LM13700/MAX30100_SaW_2022/README.md

Project for SaW course 2022, group 23, MAX30100 library. <br />
[Hardware](Hardware) - folder Altium PCB project. <br />
[Software](Software) - MAX30100 test project, also includes python script used for parsing data from sensor
