LM13700/MAX30100_SaW_2022/Documentation.pdf

Sensory w Aplikacjach Wbudowanych

# Dokumentacja techniczna

# Pulsoksymetr optyczny

Autorzy:
Mateusz Mróz
Filip Imiela

Prowadzący:
inż. mag. Jan Macheta

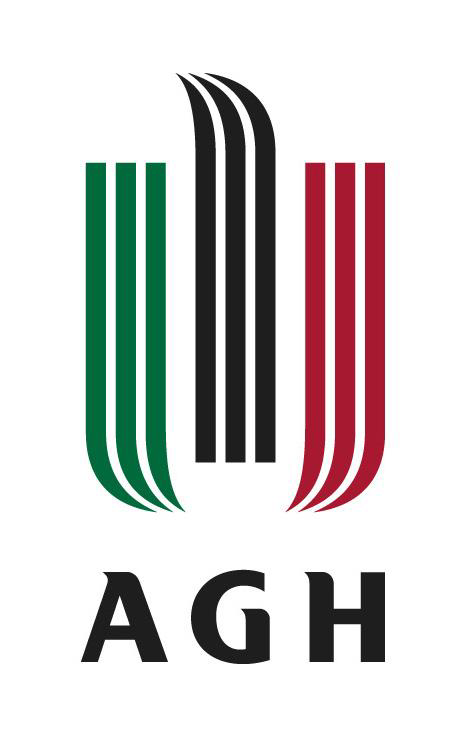
[picture p1: figure]

Kraków, czerwiec 2022

## Spis treści

## 1. Wstęp

### 1.1. Dlaczego zdecydowano się na pomiar pulsu oraz saturacji?

Pomiar tętna jest kluczowy podczas określania sprawności sercowo – naczyniowej oraz ryzyka chorób układu krwionośnego. Dodatkowo, dzięki regularnemu badaniu częstotliwości ruchu naczyń krwionośnych można określić poziom wytrenowania organizmu. U osób o wyższej kondycji fizycznej liczba uderzeń serca na minutę jest mniejsza. Pomimo tego, że pomiar pulsu na tętnicy jest preferowany przez medyków podczas oceny sił witalnych potencjalnego zmarłego, w momencie rutynowego badania wygodniej jest skorzystać z pulsometru. Pozwala on na szybszy, wygodniejszy oraz dokładniejszy pomiar bez konieczności nadmiernego angażowania pacjenta. Z powodu charakteru pomiaru tętna, wiele czujników dostępnych na rynku umożliwia również pomiar saturacji. Ważnym czynnikiem, który przyczynił się do stworzenia płyty z czujnikiem natlenienia jest COVID-19. Możliwe uszkodzenie płuc, wywołane poprzez zarażenie koronawirusem powoduje znaczny spadek nasycenia krwi tlenem (poniżej 90%, przy normalnym poziomie 95 % - 100 %). W konsekwencji prowadzi to do trudności w oddychaniu, dlatego podczas pandemii koronawirusa wskazane jest regularne badanie poziomu saturacji. Pomimo tego, że rządowy program „Domowa Opieka Medyczna” objął wszystkich pacjentów powyżej 55 lat zdiagnozowanych na COVID-19, w którym dostarczył nieodpłatnie pulsoksymetry, osoby chcące cyklicznie obserwować swój poziom nasycenia krwi tlenem muszą wyposażyć się samodzielnie w tego typu urządzenie, dlatego autorzy postanowili zaprojektować płytę umożliwiająca pomiar zarówno tętna jak i również saturacji.

### 1.2. Założenia projektowe:

- Płyta z sensorem wykorzystująca standard mikroBUS, kompatybilna z modułem SLUT (Sensor Link Utility Tool)
- Zasilanie układu z napięcia +3,3 V
- Pomiar saturacji oraz pulsu metodą optyczną odbiciową
- Komunikacja z zewnętrznym mikrokontrolerem za pomocą standardu I²C
- Wysyłanie danych pobranych z sensora poprzez UART
- Wyświetlanie pletysmografu
- Przejrzysty schemat projektowanego układu

### 1.3. Podział obowiązków

Mateusz Mróz - oprogramowanie

Filip Imiela – projekt płyty oraz montaż

### 1.4. Sposób pomiaru

Najpopularniejsze optyczne czujniki saturacji oraz tętna opierają się na dwóch metodach - odbiciowej oraz transmisyjnej. W projekcie postanowiono skorzystać z czujnika wykorzystującego odbite światło, generowane przez diodę LED. Jest to wygodniejsze rozwiązanie, ponieważ w tym przypadku nie ma elementu otaczającego opuszek palca, który jest konieczny przy pulsoksymetrach opartych o metodę transmisyjną.
Metodę pomiaru przedstawia rys. 1, zaczerpnięty z noty katalogowej wybranego zintegrowanego czujnika MAX30100.

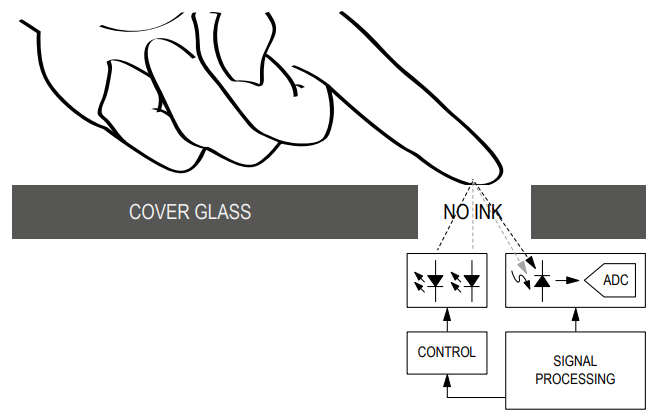
[picture p2: figure]

Rys. 1 Metoda pomiaru z wykorzystaniem odbiciowego czujnika optycznego MAX30100 (https://datasheets.maximintegrated.com/en/ds/MAX30100.pdf)

Dwie diody LED generują światło, które następnie trafia na opuszek palca. Pulsująca krew absorbuje i moduluję część promieni, a w konsekwencji na fotodiodzie powstaje fotoprąd, który jest konwertowany na postać cyfrową. Wynikiem takiego pomiaru jest pletysmograf przedstawiony na rys. 2. Aby móc uzyskać informację o natlenieniu krwi, konieczne jest wykorzystanie przynajmniej dwóch diod LED, ponieważ tkanki w odmienny sposób absorbują różne długości fali. Wartości składowych zmiennych oraz składowych stałych sygnałów przedstawionych na rys. 2 pozwalają obliczyć stopień natlenienia krwi, natomiast częstotliwość któregokolwiek przebiegu niesie informację o ilości uderzeń serca na minutę.

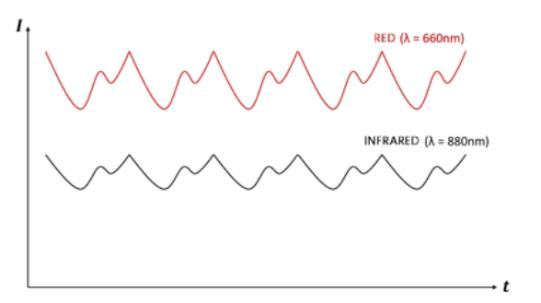
[picture p3: figure]

Rys. 2 Pletysmograf uzyskany z wykorzystaniem dwóch diod LED - czerwonej i podczerwonej (https://www.maximintegrated.com/en/design/technical-documents/app-notes/6/6845.html)

## 2. Schemat blokowy

Na rys. 3 przedstawiono schemat blokowy zaprojektowanego układu. NUCLEO-L476RG zaopatrza płytę w zasilanie 3,3 V, które zamieniane jest na 1,8 V poprzez stabilizator liniowy. Czujnik komunikuje się z mikrokontrolerem poprzez magistralę I²C. Diody LED służą do informowania pacjenta, w jakim stanie pomiaru znajduje się czujnik.

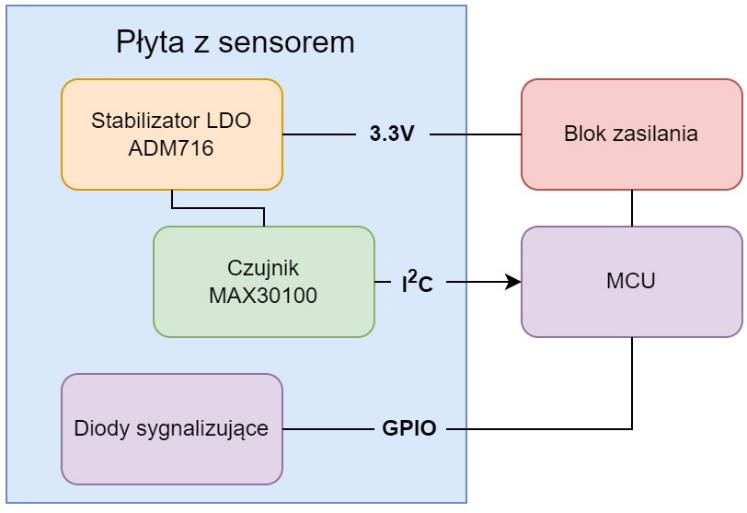
[picture p4: figure]

Rys. 3 Schemat blokowy zaprojektowanego układu

## 3. Schemat i wybór komponentów

Z powodów ograniczenia dostaw komponentów elektronicznych, w niektórych przypadkach decydującym czynnikiem wyboru elementów na płytę PCB oraz samego czujnika optycznego była dostępność wśród renomowanych dostawców, takich jak Mouser, TME czy Digi-Key.

### 3.1. Stabilizator liniowy

Zdecydowano się na wybór stabilizatora ADM7160ACPZN1.8-R2, który na wyjściu zapewnia stałe napięcie +1,8 V służące zasileniu czujnika. Zakres napięć wejściowych to (+2,2 V, +5,5 V), co pozwala na skorzystanie z obu wartości dostarczanych przez złącza modułu SLUT (+3,3 V; +5,0 V). W celu minimalizacji strat, w projekcie zdecydowano się na skorzystanie z zasilania +3,3 V. Stabilizator o wydajności prądowej 200 mA zdecydowanie wystarcza na potrzeby płyty. Dodatkowym atutem jest niewielka obudowa, dzięki której możliwe jest efektywne wykorzystanie przestrzeni dostępnej na pojedynczym slocie modułu SLUT. Zgodnie z zaleceniami producenta, dodane zostały ceramiczne kondensatory o wartościach 4,7 uF na wejściu oraz wyjściu stabilizatora.

### 3.2. Czujnik tętna i natlenienia krwi

Tak jak wspomniano, jako sensor wybrano zintegrowany MAX30100, który pozwala na pomiar zarówno tętna jak i również saturacji. Wykorzystuje czerwoną oraz podczerwoną diodę LED do badania poziomu absorbcji oraz szybkości modulacji światła przez płynącą krew. Pomiar konwertowany jest na postać cyfrową za pomocą przetwornika ADC o konfigurowalnej rozdzielczości. Minimalna wartość 10 bitów na kanał jest wystarczająca dla podstawowego zastosowania zaproponowanego w projekcie. Dodatkowo, możliwa jest konfiguracja prądu diod, co może okazać się kluczowe w rozwiązaniach low-power. Wybrany czujnik wyposażony jest w wbudowany sensor temperatury. Poprawna interpretacja pomiarów do obliczenia poziomu natlenienia krwi wymaga konkretnie ustalonej długości fali czerwonej diody. Jako, że zależy ona silnie od temperatury, dane z czujnika mogą pozwolić na kompensacje błędu związanego ze zmianą generowanego światła. Między linia zasilania a masą układu zostały dodane kondensatory odsprzęgające o typowych wartościach 1 uF oraz 100 nF. Z sensora wyprowadzono linie SDA oraz SCL do komunikacji z mikrokontrolerem na płycie Nucleo oraz pin INT – przerwanie aktywne zboczem opadającym. Ponieważ wyjścia układu dla tych pinów są z rodzaju otwarty dren, dodano niezbędne rezystory podciągające do linii zasilania. Producent zaleca, aby ich wartość była większa od 4,7 kΩ, zdecydowano się więc na zastosowanie wartości 10 kΩ. Dla wykorzystywanej prędkości komunikacji wynoszącej 400 kHz, taka wartość rezystorów podciągających nie stanowi problemu, a ponadto pozwala na zmniejszenie zużycia energii.

Rys. 4 Dioda LED, stabilizator liniowy ADM7160 oraz czujnik optyczny MAX30100

### 3.3. Tranzystory i diody LED

Diody informacyjne nie zostały podłączone bezpośrednio pod piny GPIO mikrokontrolera. Dodanie tranzystorów działających w zaproponowanej konfiguracji jako klucze pozwala na ograniczenie prądu pobieranego z samego MCU, które ma ograniczoną sumaryczną wydajność prądową GPIO (100 mA dla STM32L476RG). Z powodu możliwego obciążenia płyty SLUT dodatkowymi sensorami/układami, autorzy pracy postanowili zaproponować to rozwiązanie. Wybrane tranzystory to popularne BSH103, o napięciu progowym VGSth = 0,4 V oraz maksymalnym VDS = 30 V. Rezystor połączony szeregowo z bramką ma za zadanie ograniczenie prądu ładowania pojemności złączowych tranzystora i ochronę portów mikrokontrolera. Rezystor łączący bramkę tranzystora z jego źródłem

ADM7160ACPZN1.8-R7
LFCSP6
VOUT 1

GND

3

EN 4

VIN 6

GND

EP1

U1

INT

SDA
SCL
+3.3V | +1.8V | +1.8V

X7R

16V 0603

100nF

C4

X5R

10V 0603

1uF

C3

X5R

16V 0603

4.7uF

C1

X5R

16V 0603

4.7uF

C2

GND

GND

+3.3V

GND | GND | GND
GND | GND

GND

PGND 4

IR_DRV 5

IR_LED+ | 10
NC | 8
NC 7

R_LED+ 9

NC 1

SDA | 3
SCL | 2

VDD 11

R_DRV 6

GND 12

INT | 13
NC | 14

MAX30100

U2

LTST-C193KRKT-5A

0603

D2

0603

300R

R1

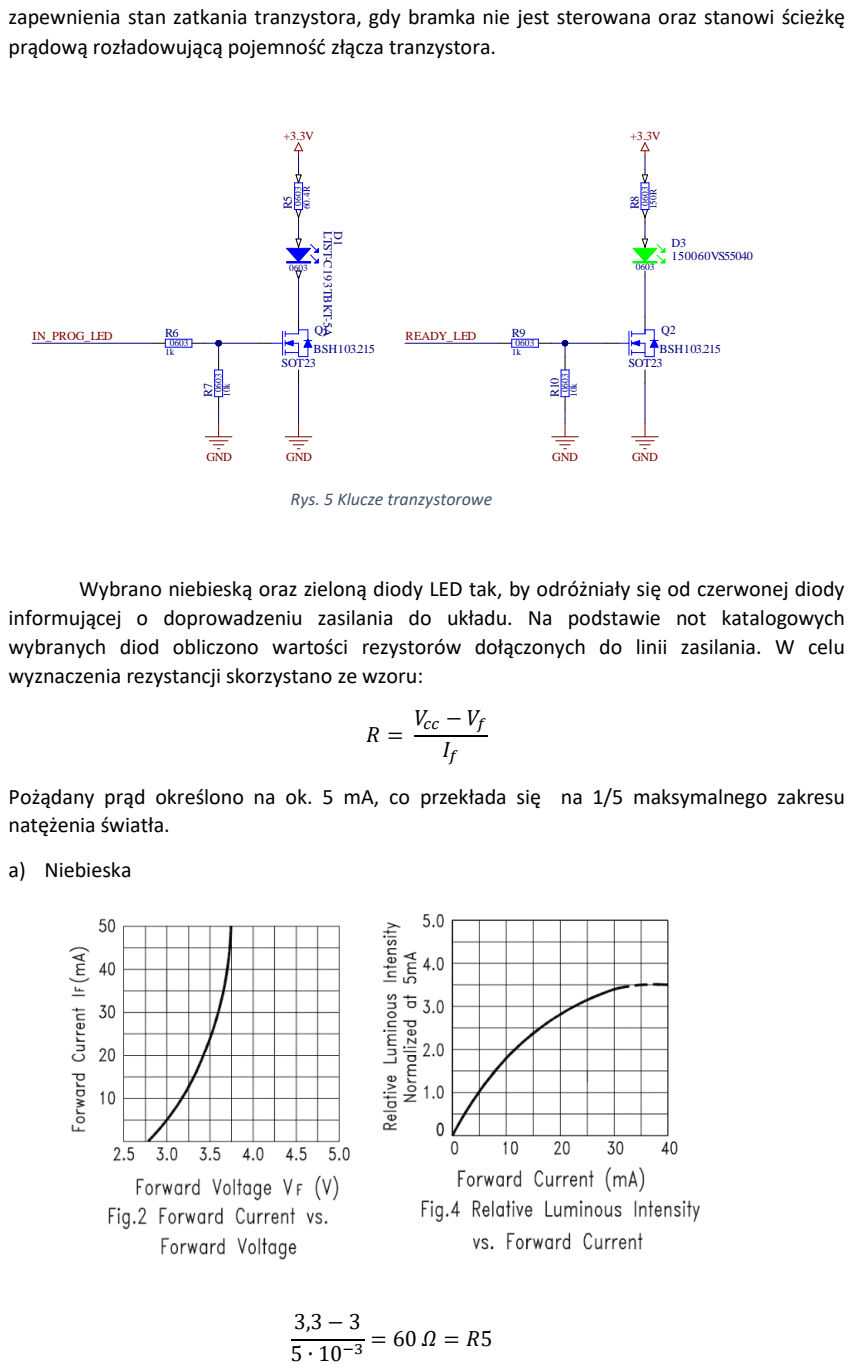
[picture p5: page 7]

zapewnienia stan zatkania tranzystora, gdy bramka nie jest sterowana oraz stanowi ścieżkę
prądową rozładowującą pojemność złącza tranzystora.

Wybrano niebieską oraz zieloną diody LED tak, by odróżniały się od czerwonej diody

informującej o doprowadzeniu zasilania do układu. Na podstawie not katalogowych
wybranych diod obliczono wartości rezystorów dołączonych do linii zasilania. W celu
wyznaczenia rezystancji skorzystano ze wzoru:

Pożądany prąd określono na ok. 5 mA, co przekłada się na 1/5 maksymalnego zakresu
natężenia światła.

b) Zielona

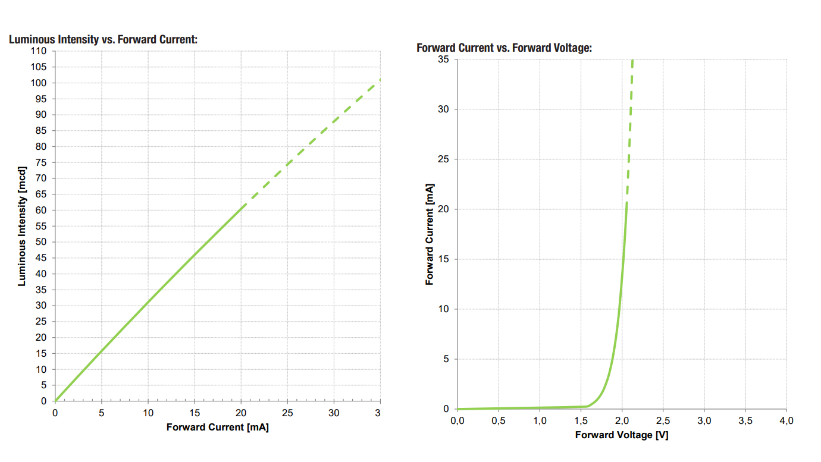
[picture p6: figure]

3,3 − 2
8 ∙ 10⁻³ = 162,5 Ω ≈ 150 Ω = R8
c) Czerwona

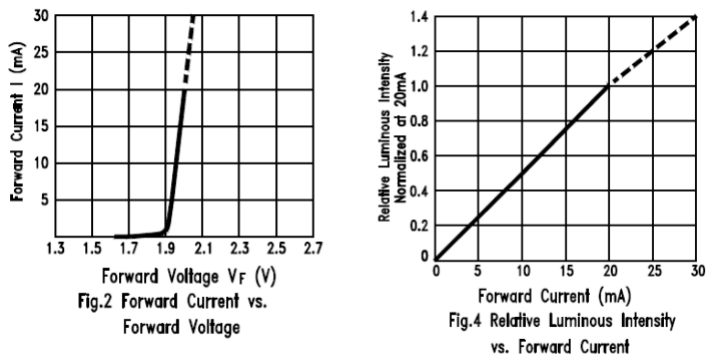
[picture p7: figure]

3,3 − 1,95
5 ∙ 10⁻³ = 270 ≈ 300 Ω = R1

### 3.4. Złącza

W celu wykorzystania płyty na module SLUT, zastosowano męskie złącza typu goldpin o rastrze 2,54 mm. Sygnały oraz zasilanie podłączono zgodnie ze standardem microBUS.

Rys. 6 Złącza kompatybilne ze standardem mikrobus

## 4. Pobór prądu

Komponent | Ilość | Pobór prądu [mA]
Czerwona dioda LED | 1 | 5
Niebieska dioda LED | 1 | 5
Zielona dioda LED | 1 | 8
Czujnik MAX30100 (13bit, 50Sps) | 1 | 1.2
Prądy diod MAX30100 | 2 | (4 – 50)
Rezystory podciągające | 3 | 0,3
SUMA | | (28 - 120)

## 5. Płyta PCB

Została zaprojektowana 2 warstwowa płyta drukowana zgodnie ze specyfikacją firmy JLCPCB, u której wykonywano produkcję. Znaczna większość komponentów znalazła się na górnej warstwie płyty. Wyjątkiem są kondensatory odprzęgające do czujnika MAX30100. Powinny one znajdować się jak najbliżej sensora, więc z uwagi na możliwe problemy z ESD umieszczono je na dolnej stronie. W celu przejrzystości opisu diod, na dolnej warstwie położono również rezystory ustalające prąd LED.

Podczas projektowania zadbano o stosowny opis komponentów oraz informacje ułatwiające obsługę płyty czujnika takie jak: podpis sygnałów na dolnej warstwie zgodnie ze standardem microBUS, podpis diod, zaznaczenie miejsca znajdowania się czujnika.

Rozmiar płyty 25,4 x 28,6 mm.

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
1x8 2.54mm
DS1021-1*8SF1-1

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
1x8 2.54mm
DS1021-1*8SF1-1

P2

GND

+3.3V

GND

+3.3V

INT

0603

10k
R2

0603

10k
R3

0603

10k
R4

SDA

SCL

READY_LED

IN_PROG_LED

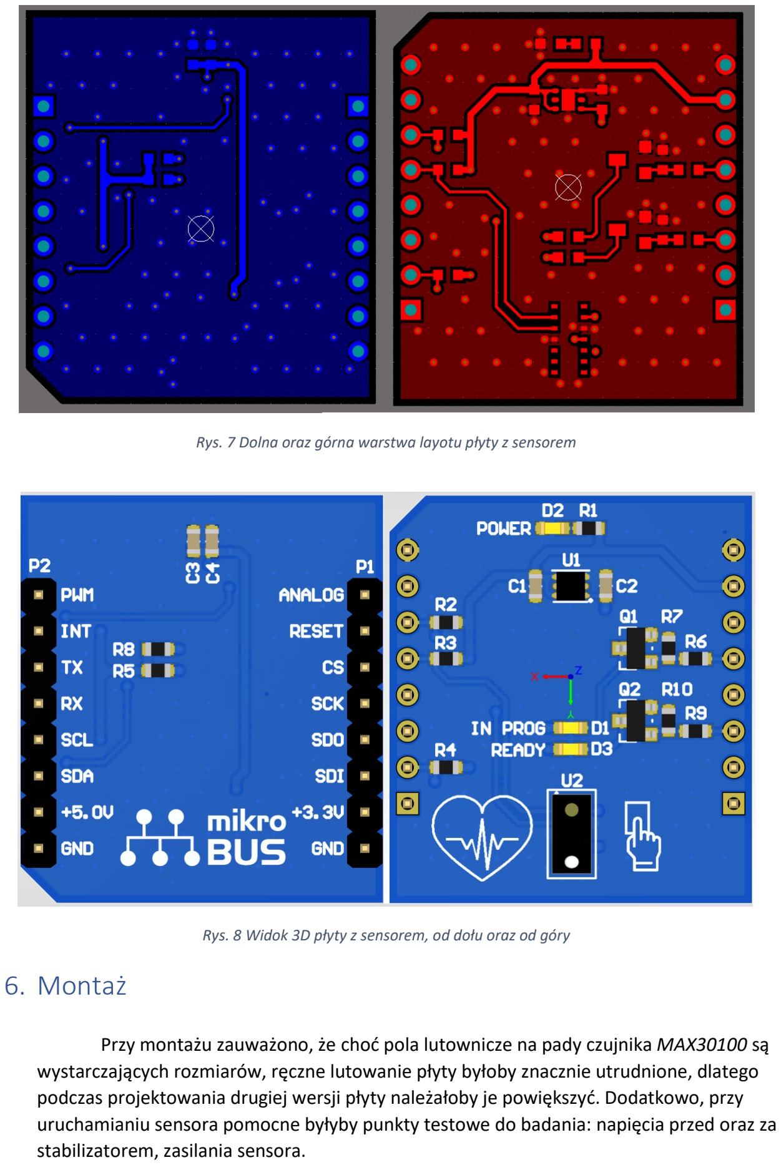
[picture p8: page 10]

Rys. 7 Dolna oraz górna warstwa layotu płyty z sensorem

Rys. 8 Widok 3D płyty z sensorem, od dołu oraz od góry

## 6. Montaż

Przy montażu zauważono, że choć pola lutownicze na pady czujnika MAX30100 są wystarczających rozmiarów, ręczne lutowanie płyty byłoby znacznie utrudnione, dlatego podczas projektowania drugiej wersji płyty należałoby je powiększyć. Dodatkowo, przy uruchamianiu sensora pomocne byłyby punkty testowe do badania: napięcia przed oraz za stabilizatorem, zasilania sensora.

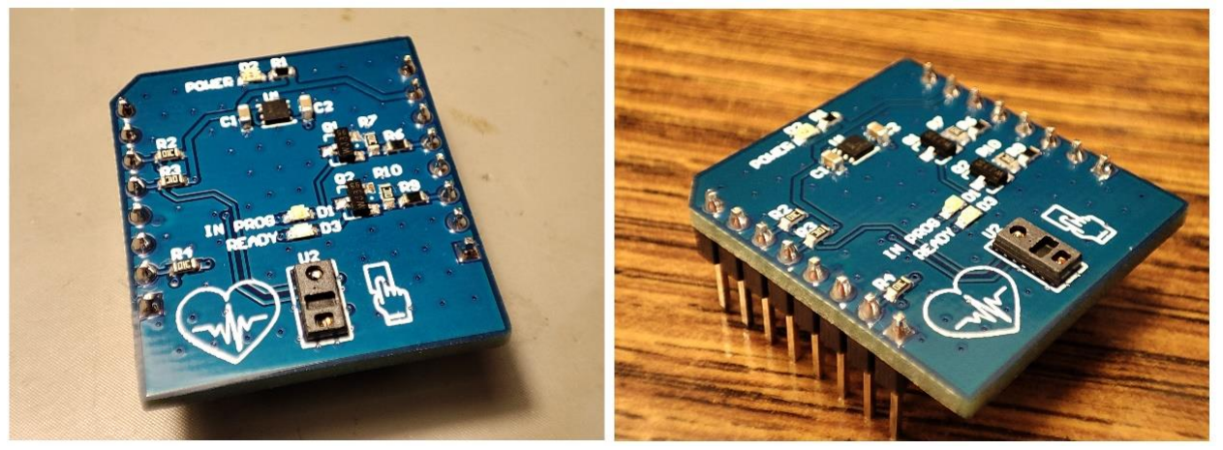
[picture p9: figure]

Rys. 9 Zdjęcia zmontowanej płyty z sensorem

Podczas wstępnych prób uruchomienia płyty zdano sobie sprawę, że nie podłączono zasilania do pinu sensora, odpowiedzialnego za doprowadzenie zasilania do zintegrowanych diod, dlatego konieczne było ich zewnętrzne podłączenie do +3,3 V, co pozwoliło na wykonanie testów układu.

## 7. Oprogramowanie

Program testujący działanie wykonanego układu został napisany w języku C, z wykorzystaniem biblioteki HAL, udostępnioną przez firmę ST. Przygotowano bibliotekę umożliwiającą obsługę komunikacji z czujnikiem. Jej API składa się z kilku funkcji:
- Max30100_Init() - funkcja inicjalizująca, sprawdza czy sensor odpowiada na próbę odczytania jego ID, a następnie resetuje go i ustawia konfigurację początkową.
- Max30100_Reset() - funkcja reset, wysyła żądanie resetu i czeka na jego wykonanie.
- Max30100_WaitForSensorStartup() - funkcja czekająca na rozpoczęcie działania sensora.
- Max30100_Write, Max30100_Read() - funkcje służące do zapisu i odczytu rejestrów sensora.
- Max30100_ReadSample() - funkcja służąca do odczytu wartości pomiarów.

W celu ułatwienia specyfikacji i skatalogowania dostępnych rejestrów, biblioteka zawiera specjalny typ wyliczeniowy.

Do operacji na polach bitowych wewnątrz rejestrów przygotowano odpowiednie makra, na styl biblioteki CMSIS.

Skonfigurowano kontroler standardu komunikacji I2C zgodnie z wytycznymi zawartymi w karcie katalogowej czujnika - wykorzystywana jest prędkość transmisji 400 kHz. Dla wejścia INT przygotowano przerwanie oraz obsłużono porty wyjściowe GPIO do sterowania diodami LED. Doświadczalnie dobrano poziom sygnału odbieranego przez fotodiodę, tak by można było włączać diodę IN_PROG informującą o rozpoczęciu pomiaru, w momencie położenia palca na sensor.

W celu komunikacji z komputerem wykorzystywany jest protokół UART.

Schemat działania przykładowego kodu został przedstawiony poniżej:

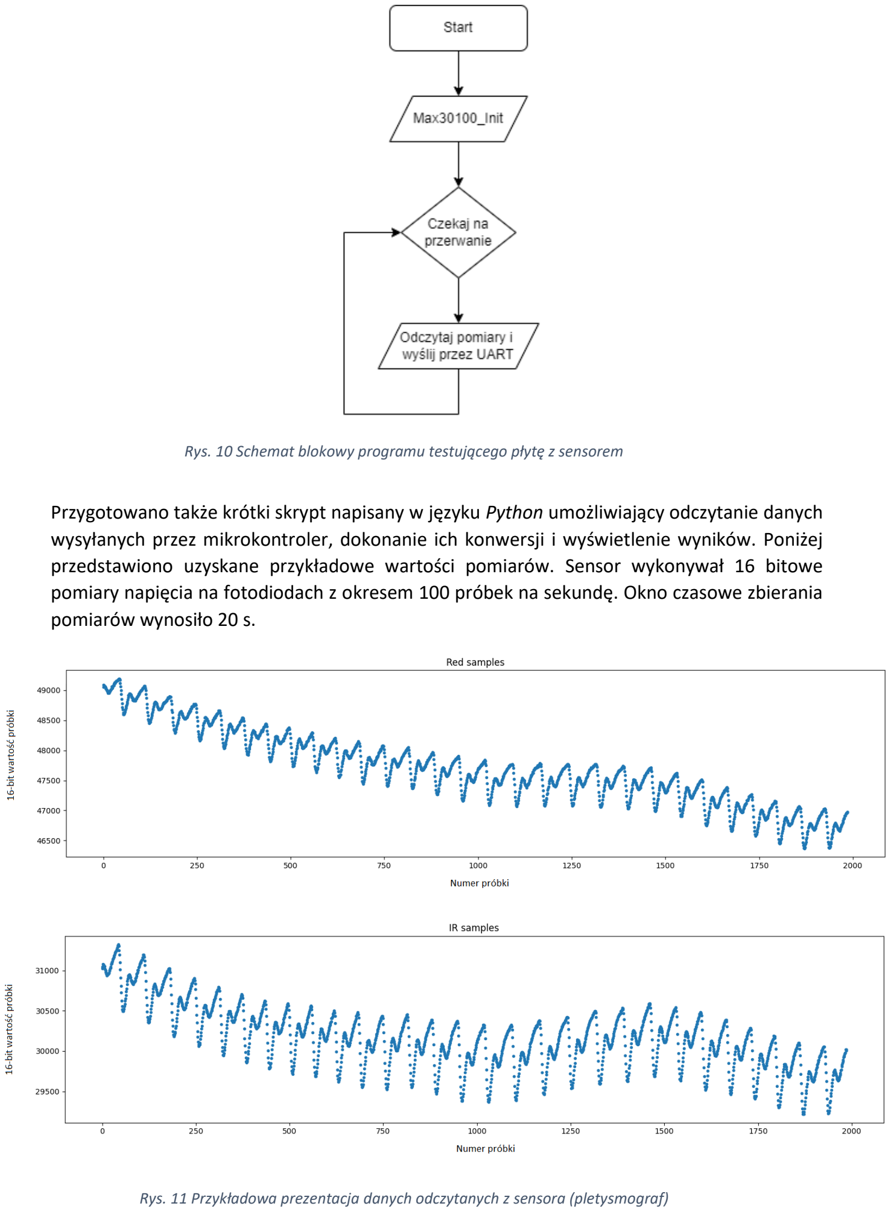
[picture p10: page 12]

Rys. 10 Schemat blokowy programu testującego płytę z sensorem

Przygotowano także krótki skrypt napisany w języku Python umożliwiający odczytanie danych wysyłanych przez mikrokontroler, dokonanie ich konwersji i wyświetlenie wyników. Poniżej przedstawiono uzyskane przykładowe wartości pomiarów. Sensor wykonywał 16 bitowe pomiary napięcia na fotodiodach z okresem 100 próbek na sekundę. Okno czasowe zbierania pomiarów wynosiło 20 s.

Rys. 11 Przykładowa prezentacja danych odczytanych z sensora (pletysmograf)

## 8. Wnioski

Założenia projektowe zostały spełnione, zaprojektowana płytka PCB umożliwia komunikację z czujnikiem MAX30100 za pomocą protokołu I2C. Mikrokontroler sterujący jest również w stanie komunikować stan pracy za pomocą diod LED. Udało się także za pomocą protokołu UART odczytać wykonane pomiary na zewnętrznym komputerze, a następnie wyświetlić je (Rys. 11). Na podstawie opisanych w punkcie wyżej parametrów pomiaru, łatwo określić, że tętno badanej osoby wynosi ok. 96 uderzeń/min. Jak już wspomniano, wyznaczanie saturacji nie jest problemem trywialnym i wymaga ono znalezienia
dodatkowych | stałych | kalibracyjnych
(https://www.maximintegrated.com/en/design/technical-documents/app-notes/6/6845.html), (https://www.maximintegrated.com/en/design/technical-documents/app-notes/6/6845.html) dla tego na podstawie zebranych pomiarów, nie da się jednoznacznie określić poziomu natlenienia krwi.
