LM13700/MAX30100_SaW_2022/(list of files, drawings)

Other design files:
Hardware/MAX30100_Sensor.SchDoc
Hardware/SENSOR_SAW.PcbDoc
Hardware/SENSOR_SAW.PrjPcb
