LM13700/MAX30100_SaW_2022/Software/Core/Src/main.c

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
/* Includes ------------------------------------------------------------------*/
#include "main.h"
#include "dma.h"
#include "i2c.h"
#include "usart.h"
#include "gpio.h"

/* USER CODE BEGIN Includes */

#include "MAX30100.h"
#include <stdio.h>

/* USER CODE END Includes */


/* USER CODE BEGIN PV */

static bool are_samples_ready = false;

/* USER CODE END PV */

void SystemClock_Config(void);
/* USER CODE BEGIN 0 */

void HAL_GPIO_EXTI_Callback(uint16_t GPIO_Pin)
{
    if(GPIO_Pin == INT_Pin)
    {
        are_samples_ready = true;
    }
}

/* USER CODE END 0 */

/**
  * @brief  The application entry point.
  * @retval int
  */
int main(void)
{
  /* USER CODE BEGIN 1 */

    uint16_t redSample;
    uint16_t irSample;
    char string[1024];
    int stringLen;

  /* USER CODE END 1 */

  /* MCU Configuration--------------------------------------------------------*/

  /* Reset of all peripherals, Initializes the Flash interface and the Systick. */
  HAL_Init();

  /* Configure the system clock */
  SystemClock_Config();

  /* Initialize all configured peripherals */
  MX_GPIO_Init();
  MX_USART2_UART_Init();
  MX_DMA_Init();
  MX_I2C2_Init();
  /* USER CODE BEGIN 2 */

  Max30100_Init(&hi2c2);

  /* USER CODE END 2 */

  /* Infinite loop */
  /* USER CODE BEGIN WHILE */
  while (1)
  {
    /* USER CODE END WHILE */

    /* USER CODE BEGIN 3 */

    if (are_samples_ready)
    {
        if (HAL_OK == Max30100_ReadSample(&redSample, &irSample))
        {
            stringLen = sprintf(string, "Red:%d IR:%d\n\r", redSample, irSample);
            if (stringLen > 0)
            {
                HAL_UART_Transmit(&huart2, (uint8_t*)string, stringLen, HAL_MAX_DELAY);
            }

            if (irSample >= MAX30100_LIGHT_THRESHOLD)
            {
                HAL_GPIO_WritePin(LED_READY_GPIO_Port, LED_READY_Pin, GPIO_PIN_RESET);
                HAL_GPIO_WritePin(LED_IN_PROG_GPIO_Port, LED_IN_PROG_Pin, GPIO_PIN_SET);
            }
            else
            {
                HAL_GPIO_WritePin(LED_READY_GPIO_Port, LED_READY_Pin, GPIO_PIN_SET);
                HAL_GPIO_WritePin(LED_IN_PROG_GPIO_Port, LED_IN_PROG_Pin, GPIO_PIN_RESET);
            }
        }
        are_samples_ready = false;
    }
  }
  /* USER CODE END 3 */
}

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
