LM13700/MAX30100_SaW_2022/Software/Core/Inc/main.h

#define B1_Pin GPIO_PIN_13
#define B1_GPIO_Port GPIOC
#define INT_Pin GPIO_PIN_2
#define INT_GPIO_Port GPIOC
#define INT_EXTI_IRQn EXTI2_IRQn
#define USART_TX_Pin GPIO_PIN_2
#define USART_TX_GPIO_Port GPIOA
#define USART_RX_Pin GPIO_PIN_3
#define USART_RX_GPIO_Port GPIOA
#define LED_READY_Pin GPIO_PIN_4
#define LED_READY_GPIO_Port GPIOA
#define LD2_Pin GPIO_PIN_5
#define LD2_GPIO_Port GPIOA
#define TMS_Pin GPIO_PIN_13
#define TMS_GPIO_Port GPIOA
#define TCK_Pin GPIO_PIN_14
#define TCK_GPIO_Port GPIOA
#define LED_IN_PROG_Pin GPIO_PIN_11
#define LED_IN_PROG_GPIO_Port GPIOC
#define SWO_Pin GPIO_PIN_3
#define SWO_GPIO_Port GPIOB
