LM13700/MAX30100_SaW_2022/(commit log)

2022-06-13 Add leds driving
2023-05-28 Copy repo from SVN to Git
    [MAX30100_Sensor.SchDoc, SENSOR_SAW.PcbDoc, SENSOR_SAW.PrjPcb]
