LM13700/MAX30100_SaW_2022/(notices)

Notices in the files:
Software/Core/Src/main.c:
Copyright (c) 2022 STMicroelectronics.
All rights reserved.
This software is licensed under terms that can be found in the LICENSE file
